Adam-Sidor/CAN_Cluster/CAN_Cluster_ESP32/secrets.example.h

// Copy this file as secrets.h (not in the repository) and fill in your data to enable OTA updates.
#define WIFI_SSID "your-wifi"
#define WIFI_PASSWORD "your-wifi-password"
#define OTA_PASSWORD "your-ota-password"  // asked by Arduino IDE when uploading over the network
