Adam-Sidor/CAN_Cluster/(commit log)

2024-12-06 RPM issue fixed. Again - when there is var name without value on serial
    [CAN_Cluster.ino]
2024-12-22 Schematic image added
2024-12-23 Temp sensor added
2024-12-23 Fixed issue with changing lights while driving
    [CAN_Cluster.ino]
2026-10-30 ESP32 version with Bluetooth added
2026-10-30 ESP32 Bluetooth debug output and last value parsing
2026-10-30 Cruise control added to ESP32 version
2026-10-30 ESP32 parsing, blinker, time and fuel fixes ported to Uno version
2026-10-30 ESP32 check control warnings, BC buttons and CAN debug tools added
2026-10-30 ESP32 fuel consumption gauge and ETS2 damage warnings added
2026-10-30 Uno warnings, fuel gauge and cruise control added, BC buttons removed
2026-10-30 SimHub damage warnings reworked: chassis, cargo and trailer
2026-10-30 ESP32 Wi-Fi OTA updates and check control ID scan added
2026-10-30 ESP32 ccScan command fixed, command replies sent over Bluetooth too
2026-10-31 SimHub warnings: graduated damage, beacon, hitch, gear selector, FH5 skid, engine-off filter
